pcs-electronics/miniocxo/HARDWARE/miniocxo_kicad.pdf

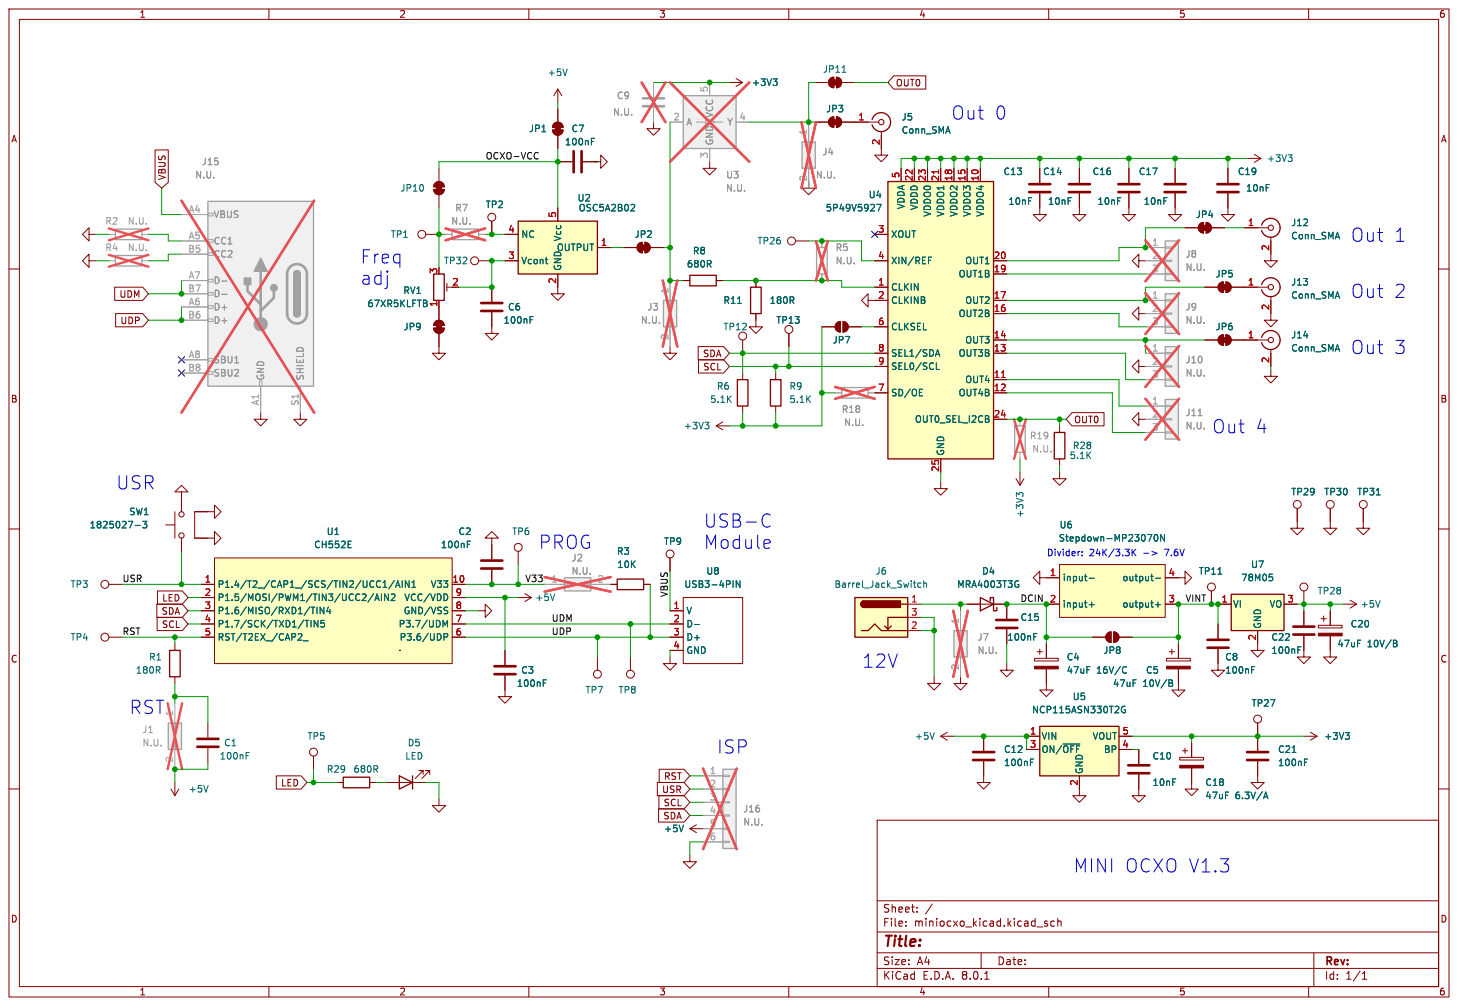
[picture p6: page 1]

5 CLKSEL 6 SD/OE 7 SEL1/SDA 8 SEL0/SCL 9 U4

5 CLKSEL 6 SD/OE 7 SEL1/SDA 8 SEL0/SCL 9

2 ON/~{OFF} 3 BP 4 VOUT 5 C4

2 ON/~{OFF} 3 BP 4 VOUT 5 U5 NCP115ASN330T2G

Id: 1/1 Title: File: miniocxo_kicad.kicad_sch Sheet: /
